liyuzhu1998/PFU_Detection_Hardware/(list of files, cad)

Other CAD files:
LD_holder_p1_v2.ipt
LD_holder_p2_vExdention.ipt
LD_holder_p3.ipt
LD_holder_p4.ipt
LD_holder_p5.ipt
frame-holder-v3.ipt
frame-holder-v3_MIR.ipt
incubator-chamber-holder.ipt
master-slider-mirror-v2.ipt
master-slider-motor_v2.ipt
plate-holder.ipt
sensor-holder-v3.ipt
sensor-house-reflection_v5.ipt
slave-slider-house.ipt
