liyuzhu1998/PFU_Detection_Hardware/Assembling Instruction_vF.pdf

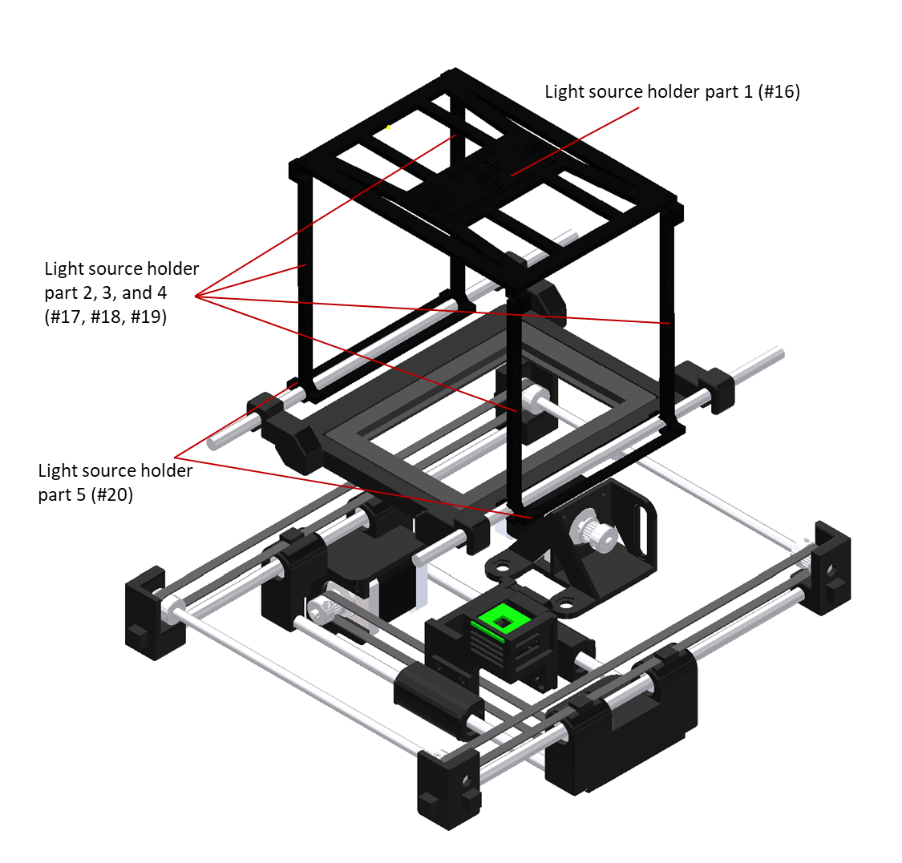
[picture p7: figure]
